gabriel-tenma-white/qn8007_fm_tx/ant1.jpg

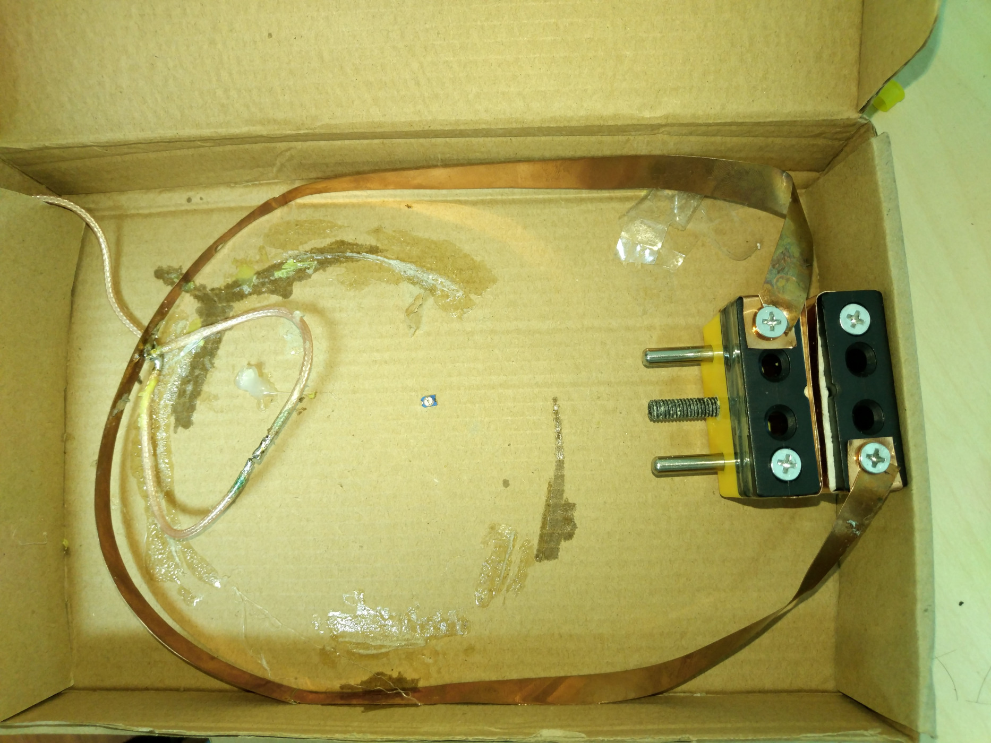
ant1.jpg
