gabriel-tenma-white/qn8007_fm_tx/ant2.jpg

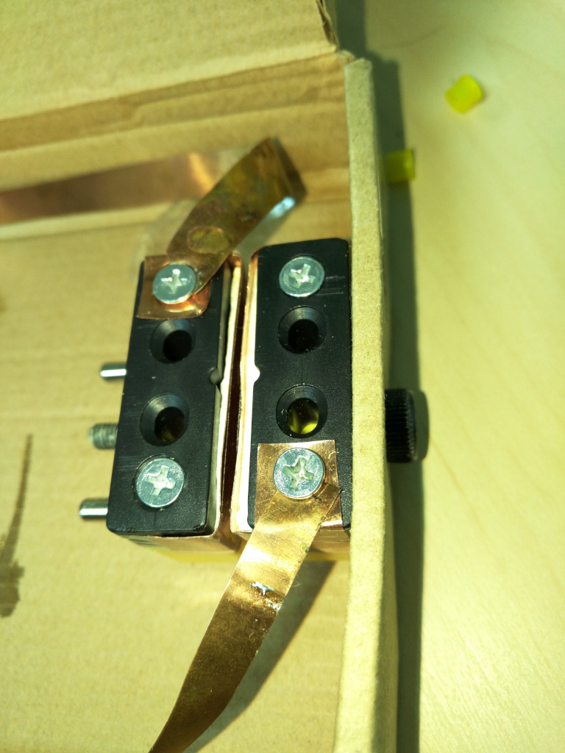
ant2.jpg
