gabriel-tenma-white/qn8007_fm_tx/qn8007_fm_tx.png

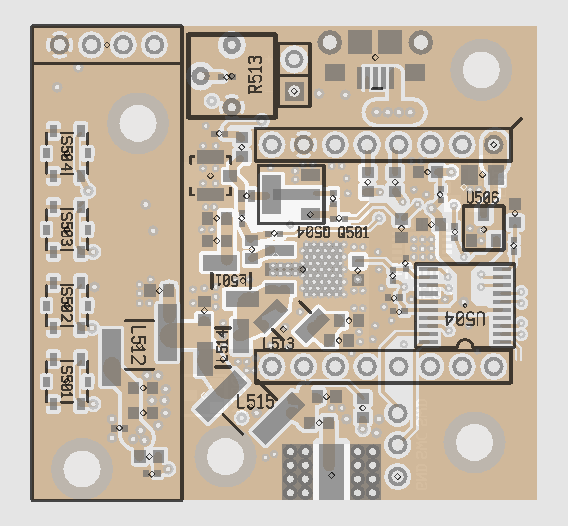
qn8007_fm_tx.png
