gabriel-tenma-white/qn8007_fm_tx/assembly.png

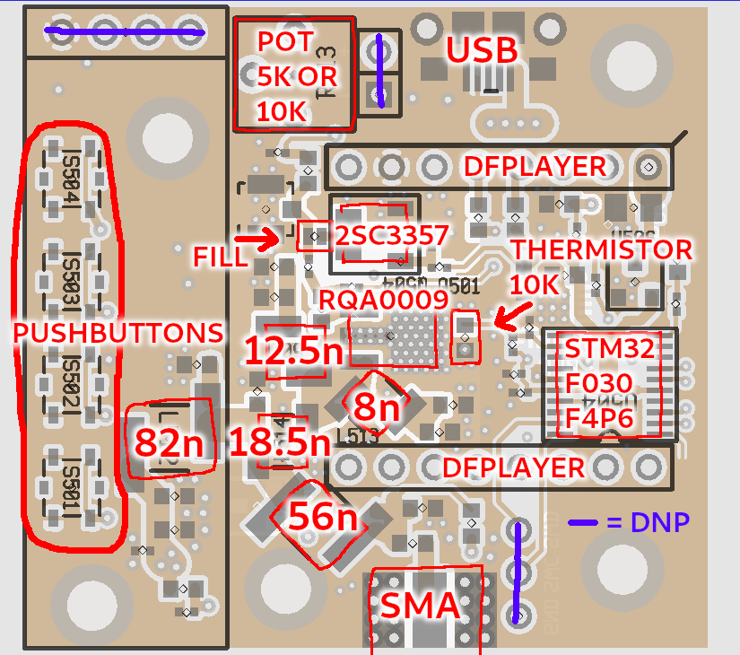
assembly.png
