gabriel-tenma-white/qn8007_fm_tx/assembly_bottom.png

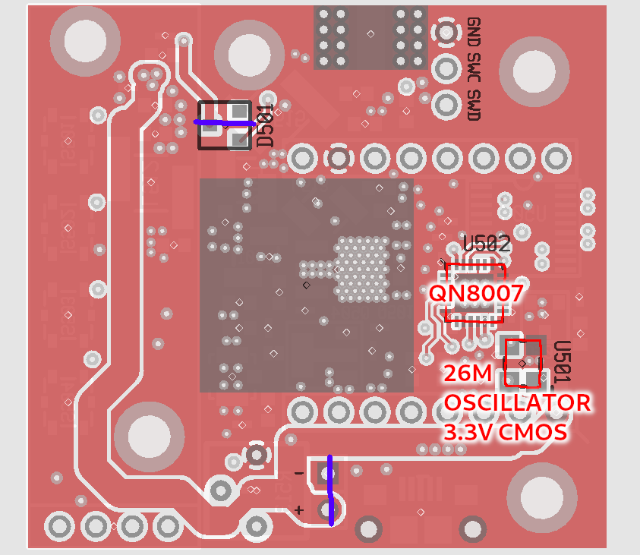
assembly_bottom.png
