gabriel-tenma-white/qn8007_fm_tx/(list of files, drawings)

Other design files:
qn8007_fm_tx_2.pcb
