gabriel-tenma-white/qn8007_fm_tx/(commit log)

2019-04-24 sw: fix bug with GPIOF not enabled
    [opencm3_wiring_stm32f0.H]
2020-03-21 add assembly diagrams
