gabriel-tenma-white/qn8007_fm_tx/(notices)

Notices in the files:
sw/main2.C:
This library is free software: you can redistribute it and/or modify
it under the terms of the GNU Lesser General Public License as published by
the Free Software Foundation, either version 3 of the License, or
(at your option) any later version.
